niko-dunixi/Arduino-Haptic-Ophthalmic/experimental-code/DistanceSensor_withLEDs/DistanceSensor_withLEDs.ino

int trigPin = 11;    //Trig - green Jumper
int echoPin = 12;    //Echo - yellow Jumper
long duration, cm;

//LED output pins
int led1 = 9;
int led2 = 8;
int led3 = 7;
int led4 = 6;
int led5 = 5;
 
void setup() {
  //Serial Port begin
  Serial.begin (9600);
  //Define inputs and outputs
  pinMode(trigPin, OUTPUT);
  pinMode(echoPin, INPUT);

  //LED line
  pinMode(led1, OUTPUT);
  pinMode(led2, OUTPUT);
  pinMode(led3, OUTPUT);
  pinMode(led4, OUTPUT);
  pinMode(led5, OUTPUT);
}
 
void loop()
{
 
 
  // The sensor is triggered by a HIGH pulse of 10 or more microseconds.
  // Give a short LOW pulse beforehand to ensure a clean HIGH pulse:
  digitalWrite(trigPin, LOW);
  delayMicroseconds(5);
  digitalWrite(trigPin, HIGH);
  delayMicroseconds(10);
  digitalWrite(trigPin, LOW);
 
  // Read the signal from the sensor: a HIGH pulse whose
  // duration is the time (in microseconds) from the sending
  // of the ping to the reception of its echo off of an object.
  pinMode(echoPin, INPUT);
  duration = pulseIn(echoPin, HIGH);
 
  // convert the time into a distance
  cm = (duration/2) / 29.1;
  
  Serial.print(cm);
  Serial.print("cm");
  Serial.println();

  if (cm < 100){
    digitalWrite(led1,HIGH);

    if (cm < 75){
      digitalWrite(led2, HIGH);

      if (cm < 50){
        digitalWrite(led3, HIGH);
        
        if (cm < 25){
          digitalWrite(led4, HIGH);

          if (cm < 10){
            digitalWrite(led5, HIGH);
          }
        }
      }
    }
  }
  
  delay(250);
  
  digitalWrite(led1, LOW);
  digitalWrite(led2, LOW);
  digitalWrite(led3, LOW);
  digitalWrite(led4, LOW);
  digitalWrite(led5, LOW);
  
  
}
