niko-dunixi/Arduino-Haptic-Ophthalmic/(commit log)

2016-09-29 Adding prototype code
2016-10-04 Quasi stable sketch. Second sensor isn't reading back information. Already determined it is not an issue with the sensor. It is either my wiring or my code.
2016-10-04 Found a fix. Can now read both sensors. It's not very elegant, but there might be a better fix.
2016-10-04 Cleaning up. Sensors are now discrete.
2016-10-05 Switching from pointers for the time being
2016-10-05 added missing newline character
    [HapticResponse.cpp]
2016-10-13 Three Sensor Test
    Attempting to test the circuit with three sensors
2016-10-14 wrote analogWrite code for motor
    This is a super simple example of how to set up the motor on the nano
    using an analog signal to make varying degrees of vibration.
    [Motorwrite1.ino]
2016-10-14 wrote initial distanceSensorWithOneMotor sketch
    created a sketch that runs the motor based on the distance from the
    sensor
2016-10-14 added writeMotor function
    created a function to write the motor speed so we can extrapolate it to
    multiple motors
2016-10-15 added scalability
    converted sensor/motors to multi-dimensional array for scalability
    created getDistanceFromSensor function
    cleaned up code
2016-10-20 Adding script to get arduino to run on linux
2016-10-26 Still need to bring writeMotor into loop()
    I've gone through the goggle code, and just commented out what Paul has
    supplied. Attempting to use some of the example from NewPing library,
    but still need to account for outputting to the motor in the loop().
2016-11-12 Mothheah Effn prototype YO
2016-11-27 tested on board
    algorithm to determine array.length wasn't working so I hard coded it to
    3
